airball-aero/airball-mechanical/probe/v8/cad/toplevel_assy.step

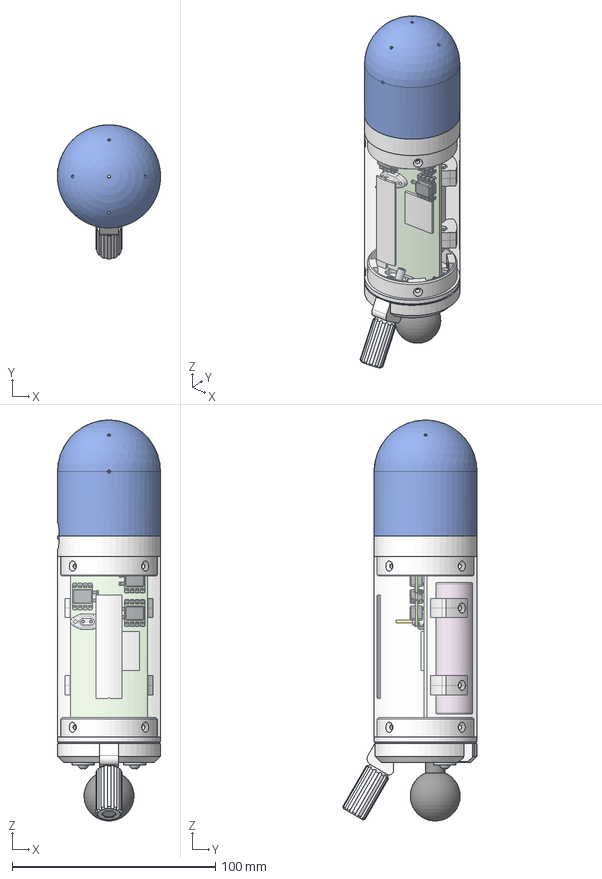
[picture p1: CAD file, 2021-01-17]
probe/v8/cad/toplevel_assy.step
50.8 x 66.2 x 197.5 mm
antenna_mount
battery_bracket x 4
battery
body_tube
Round head machine screw #4-40 x 0.625 x 2
Hex machine screw nut #8-32
Hex head machine screw #8-32 x 2
nut_knob
mounting_plate_nubbin
standoff_#4_3/8 x 2
Type B wide flat washer #4 x 2
ball_mount
back_cover
mounting_plate
nose_support
nose_ball_hollow
hose_adapter_0.5 x 2
baro_shroud
50039315-001_SW0001 x 3
pcb_oat
4x1_socket
pcb
