airball-aero/airball-mechanical/(commit log)

2021-01-17 CAD files for probe v8
    [toplevel_assy.step]
2021-01-17 Ongoing work on probe kit build instructions
